Gon21513/RedisenoPEP/README.md

# Desarrollo de una placa de expansión para los agentes Pololu 3Pi+ que expanda sus capacidades dentro del ecosistema Robotat.
Este trabajo se desarrolló con el objetivo de **ampliar las capacidades de los agentes Pololu 3Pi+** utilizados en la plataforma de pruebas **Robotat**.  
Para lograrlo, se implementaron distintos módulos de expansión y funciones adicionales que extienden el alcance operativo del agente.

En primer lugar, se integraron **servomotores Feetech FT90M**, los cuales permiten dotar al agente de movimiento adicional y control de orientación en componentes periféricos.  
Asimismo, se incorporó una **cámara OpenMV Cam H7**, que permite **capturar imágenes o transmitir video en tiempo real** desde la perspectiva del agente. Esta cámara puede utilizarse tanto para realizar un *livestream* durante la ejecución de rutinas como para capturar fotogramas en momentos clave de operación.

Adicionalmente, se desarrolló un **algoritmo de estacionamiento automático** que posibilita el retorno del agente a una posición predefinida, evitando obstáculos en la plataforma. Esta funcionalidad contribuye a la automatización del proceso de pruebas y asegura un funcionamiento consistente del agente.

Todas las expansiones y el propio agente son controlados por un **TinyS3 (ESP32-S3)**, que proporciona comunicación **Wi-Fi** y permite la interacción desde un **cliente remoto**.  
El sistema fue diseñado para admitir instrucciones simples y extensibles, facilitando la integración con **múltiples lenguajes de programación**.

Este repositorio se basa en y utiliza como punto de partida parte del trabajo original desarrollado por **José Luis Álvarez Pineda**, disponible en el siguiente repositorio: 
[https://github.com/JoseLuisA-P/Tesis-ESP32-Pololu](https://github.com/JoseLuisA-P/Tesis-ESP32-Pololu)

El presente proyecto **extiende, adapta y optimiza** dicho trabajo para incorporar nuevas funcionalidades orientadas al control modular, la comunicación con cámara, el manejo de servomotores y la automatización de rutinas del agente dentro del entorno Robotat.
<center>
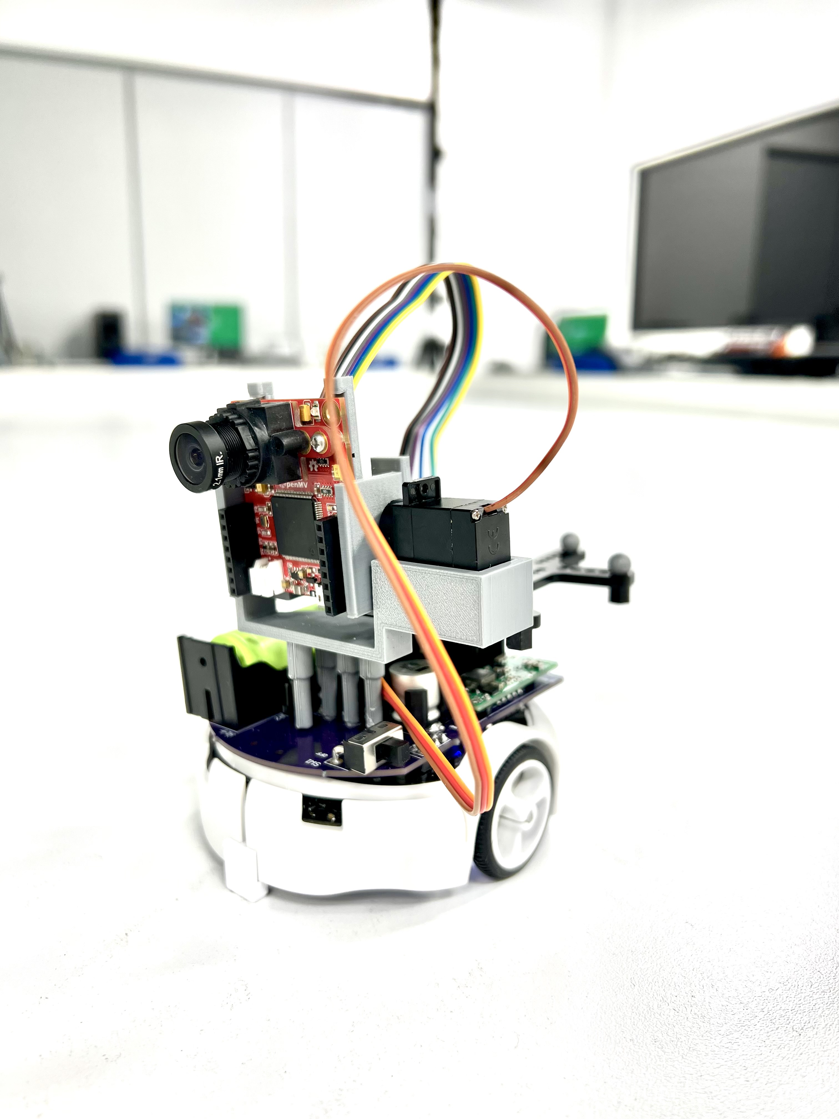
[picture p1: assets/IMG_4246.jpg]
  
</center>

Que contiene este repositorio:
- El firmware utilizado por la placa TinyS3.
- Los códigos para el control del agente y módulos desde Python.
- Manual para el ensamble de las placas de expansion y los modulos.
- Videos del funcionamiento general del sistema.
- Enlaces a las pruebas y validación del agente.

### Tabla de contenido:
- [Plataforma de trabajo](#Plataforma-de-trabajo)
- [Estructura del repositorio](#Estructura-del-repositorio)
- [Como ensamblar los modulos y placas](#Como-ensamblar-los-modulos-y-placas)

### Plataforma de trabajo

Platformio y ESPRESSIF

El firmware del agente se desarrolló utilizando la plataforma PlatformIO en VSCode, junto con el framework de ESP-IDF desarrollado como una extensión por ESPRESSIF. La elección de VSCode para este proyecto se debe a su alta flexibilidad para configurar el entorno de desarrollo, desde las alertas visuales hasta el manejo de errores y las diversas extensiones para interactuar con módulos y bibliotecas. Además, su fácil integración con GitHub y la gestión de versiones permitieron un desarrollo más eficiente.

Se utilizó la extensión de PlatformIO debido a las diversas herramientas que contiene para programar y preparar los entornos de trabajo para diversas placas y microcontroladores. Esta extensión permite crear proyectos específicos para cada placa, configurar sus características de manera sencilla, seleccionar las versiones del lenguaje a utilizar y manejar los errores de compilación. En el lado físico, permite programar las placas desde VSCode, utilizar el monitor serial para leer los mensajes de error y configurar acorde al puerto y velocidad de comunicación con la placa. Además, facilita compilar el proyecto y verificar los errores al cargar datos a las placas.

El framework de ESP-IDF se eligió principalmente por la fácil integración de FreeRTOS, lo que permite aprovechar al máximo las capacidades de la placa y optimizar su rendimiento multitarea. Además, este framework permite utilizar las bibliotecas desarrolladas por ESPRESSIF para un manejo eficiente de los módulos de las placas basadas en ESP32, proporcionando mayor flexibilidad en su configuración y permitiendo el uso del multiplexado de los pines para los distintos módulos.

Altium Designer

Para el desarrollo de las PCBs, se utilizó Altium Designer 2022. Aunque este software permite el uso de librerías de objetos comunes, fue necesario agregar librerías personalizadas para cada uno de los componentes adquiridos localmente sin un modelo definido. La elección de Altium Designer se debe a la variedad de herramientas que ofrece para el desarrollo de PCBs y la facilidad para modificar e interconectar proyectos.

Inventor

# Estructura del repositorio

El repositorio se encuentra organizado en las siguientes carpetas principales:

- **[PruebasCOMS](/PruebasCOMS)**  
  Contiene el proyecto utilizado para la configuración y generación del firmware del **TinyS3 (ESP32-S3)**, incluyendo los módulos de comunicación, control y manejo de periféricos.

- **[assets](/assets)**  
  Incluye las imágenes de referencia utilizadas dentro de este repositorio y en la documentación del proyecto.

- **[Videos](/Videos)**  
  Almacena videos que documentan el funcionamiento general del sistema.

- **[ControlCliente](/ControlCliente)**  
  Incluye los scripts desarrollados en **Python** para el control remoto del agente robótico, la comunicación con el TinyS3 y la visualización de datos.

- **[Camara](/Camara)**  
  Reúne los programas relacionados con la **comunicación y transmisión de video** entre el **TinyS3** y la **OpenMV Cam H7**.  
  Contiene los siguientes subapartados:

  - **openmv_stream**: código que debe cargarse directamente en la cámara OpenMV. Captura imágenes y las envía por SPI hacia el TinyS3.  
  - **PruebaCamara**: script para PC (VS Code, Thonny, etc.) que recibe y visualiza el streaming enviado por el microcontrolador.  
  - **MovimientoCamaraServo**: prueba para validar el control del servomotor encargado de orientar la cámara mediante el módulo MCPWM del TinyS3.  
  - **PruebasCamara**: código general de verificación de la cámara (inicialización, SPI, transmisión). Permite probar el streaming del sistema completo.  
  - **PruebaServoCamara**: ensayo que combina el control del servo y la captura de video, verificando la sincronización entre ambos.  

- **[Pruebas_Servos](/Pruebas_Servos)**  
  Códigos empleados para probar individualmente los servomotores conectados a la placa, comprobando amplitud angular, suavidad de movimiento y calibración PWM.

- **[PruebasBateria](/PruebasBateria)**  
  Programa de medición del nivel de batería mediante el ADC interno del ESP32-S3. Permite validar la correspondencia entre el voltaje medido y el estado real de la celda.

- **[ServosyRuedas](/ServosyRuedas)**  
  Código de prueba que controla únicamente las **ruedas y servos**, sin incluir el módulo de cámara. Se usa para calibración rápida del sistema de tracción.

- **[Servos_Ruedas_CAMARA](/Servos_Ruedas_CAMARA)**  
  Firmware que integra el **control de ruedas, servomotores y cámara** en una secuencia de pruebas completas:
  1. Movimiento de ruedas por un intervalo definido.  
  2. Movimiento de los servos de orientación.  
  3. Activación y verificación del streaming de la cámara.

### Como ensamblar los modulos y placas

Para ensamblar los módulos y placas utilizados en este trabajo, puede hacer referencia al documento **"ManualPololu.pdf"**. En este documento, encontrará una breve descripción de las placas, así como instrucciones detalladas sobre cómo ensamblar las placas y módulos. Además, se proporciona información sobre cómo montarlos y detalles sobre otros materiales adicionales que podrían ser necesarios en el proceso.

En el proceso de ensamblaje, se incluyen referencias a pruebas creadas para observar el correcto funcionamiento del agente antes de desplegarlo, lo que facilita el diagnóstico durante su ensamblaje.
