Gon21513/RedisenoPEP/figuras/figuras/altiumrv4.png

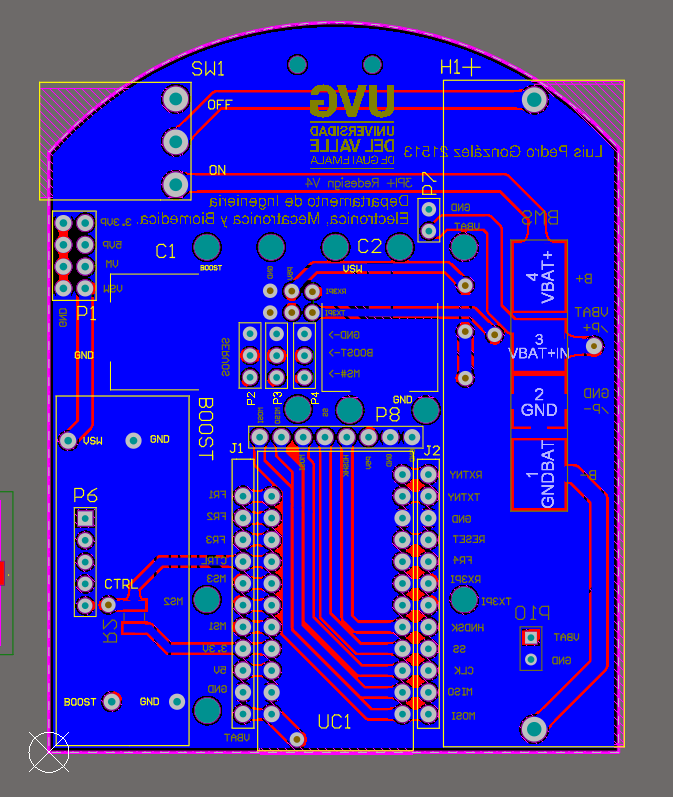
figuras/figuras/altiumrv4.png
