Gon21513/RedisenoPEP/figuras/figuras/altiumrv5.png

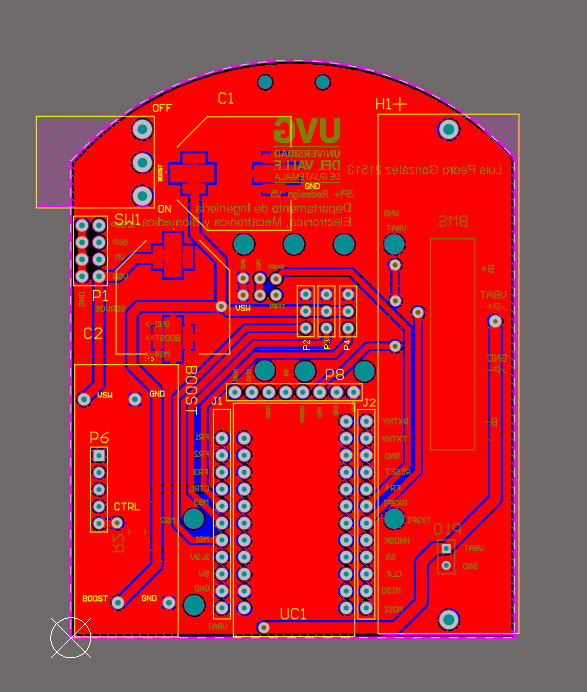
figuras/figuras/altiumrv5.png
