Gon21513/RedisenoPEP/figuras/figuras/basecamara.png

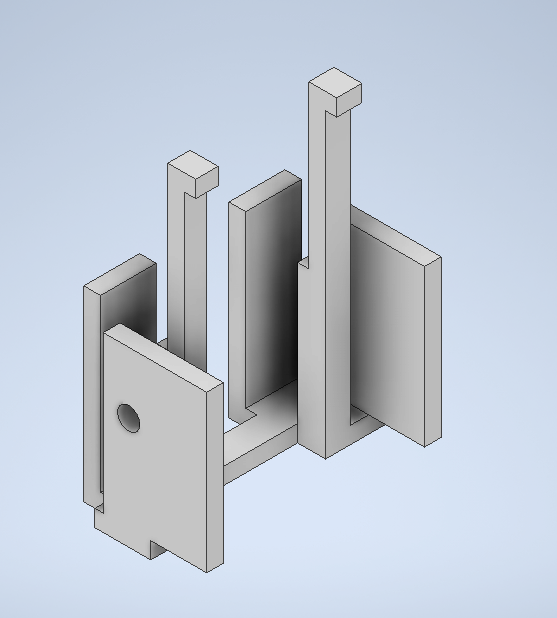
figuras/figuras/basecamara.png
