Gon21513/RedisenoPEP/figuras/figuras/basecamarafinal.png

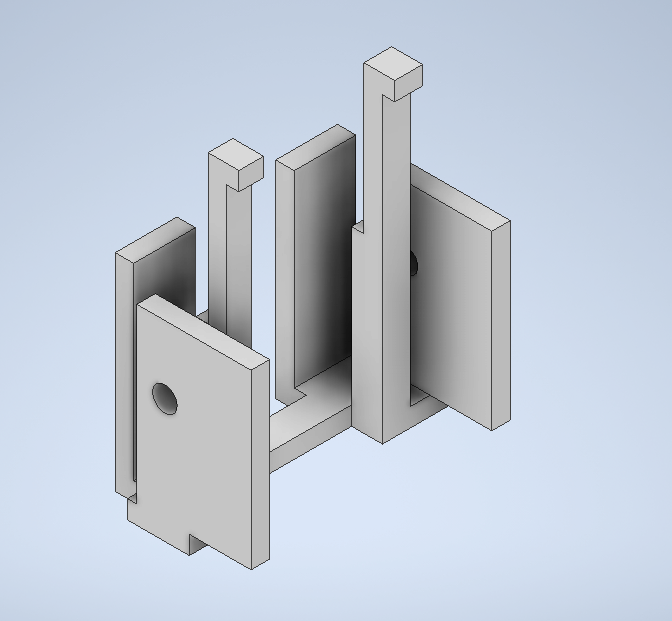
figuras/figuras/basecamarafinal.png
