Gon21513/RedisenoPEP/figuras/figuras/diagramaconexiones.png

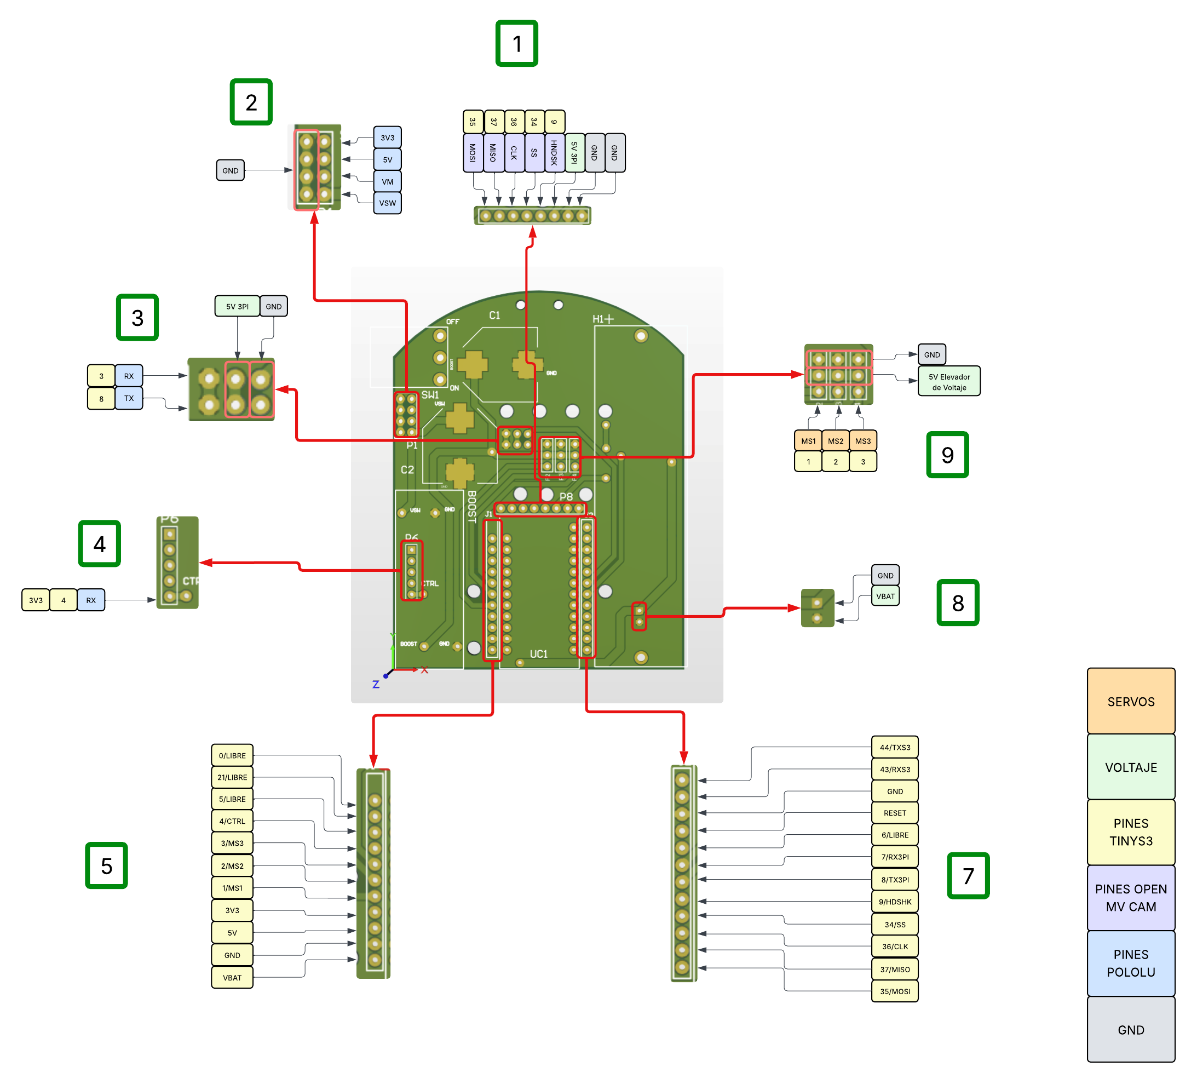
figuras/figuras/diagramaconexiones.png
