Gon21513/RedisenoPEP/figuras/figuras/diagramapolulu.png

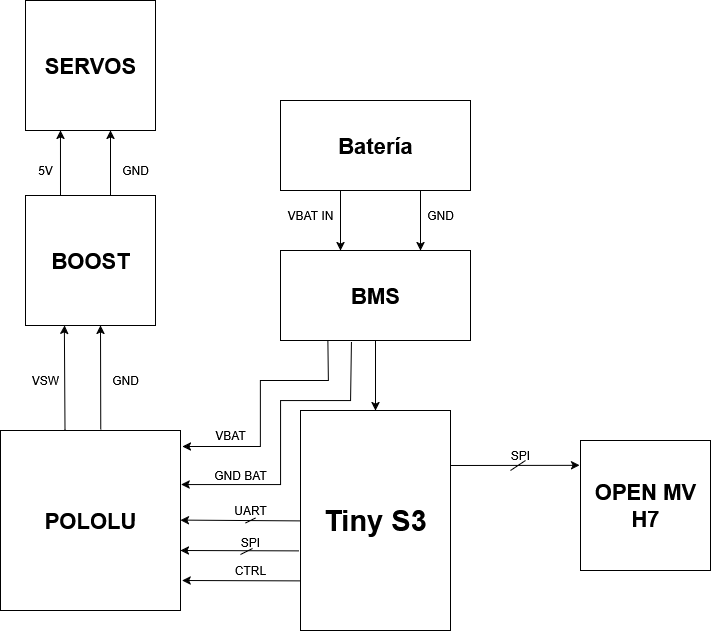
figuras/figuras/diagramapolulu.png
