Gon21513/RedisenoPEP/figuras/figuras/distribucion.png

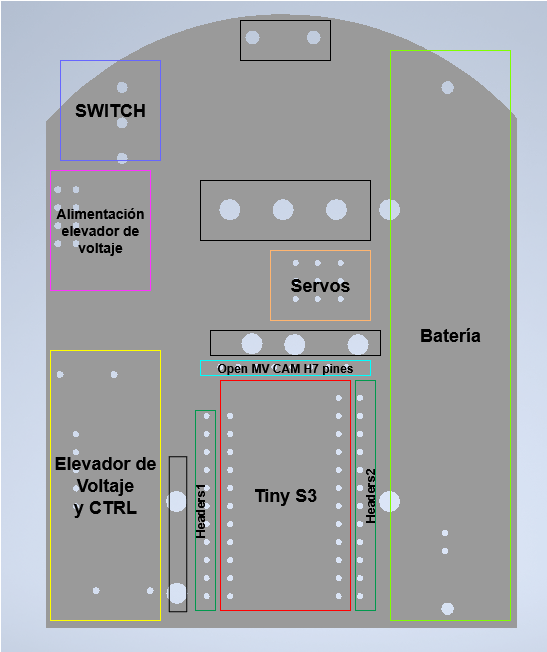
figuras/figuras/distribucion.png
