Gon21513/RedisenoPEP/figuras/figuras/Placa2025.jpg

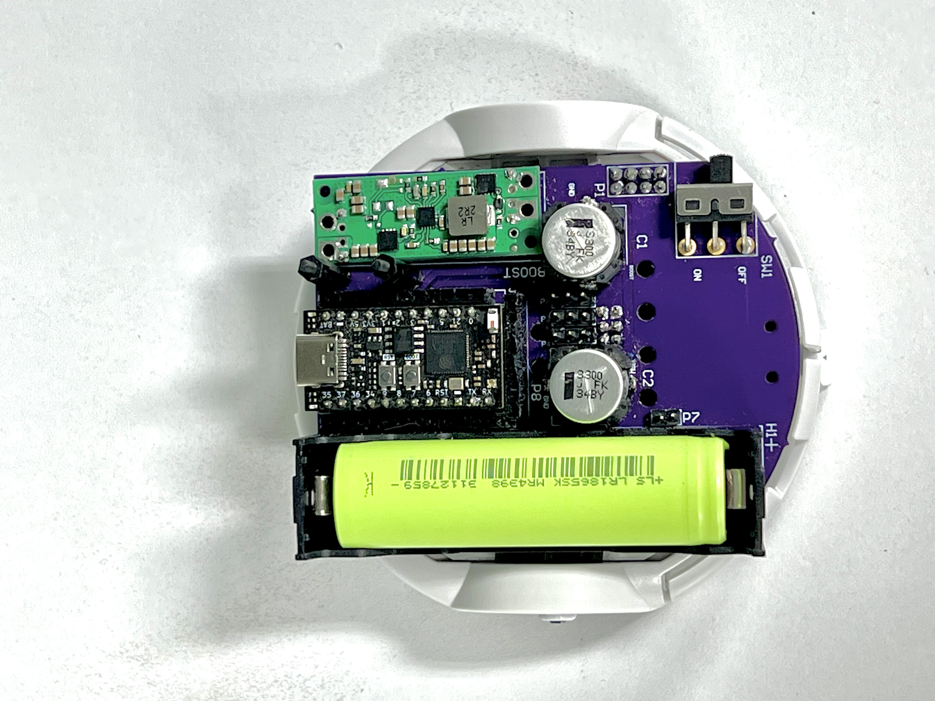
figuras/figuras/Placa2025.jpg
