Gon21513/RedisenoPEP/figuras/figuras/placarv5.png

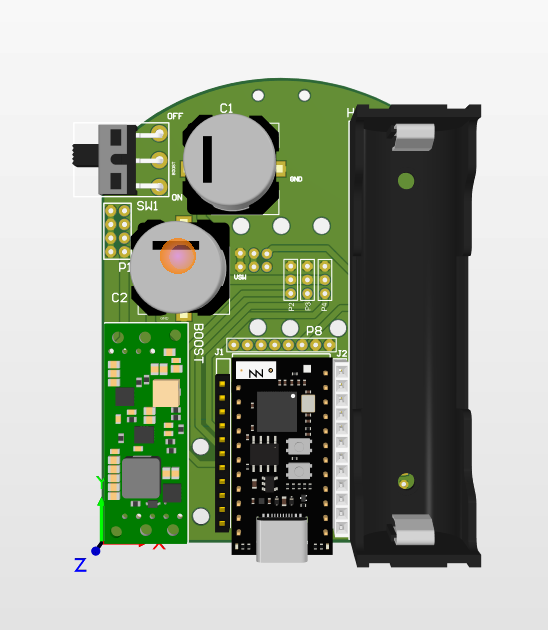
figuras/figuras/placarv5.png
