Gon21513/RedisenoPEP/figuras/figuras/VistaGeneral2024.jpeg

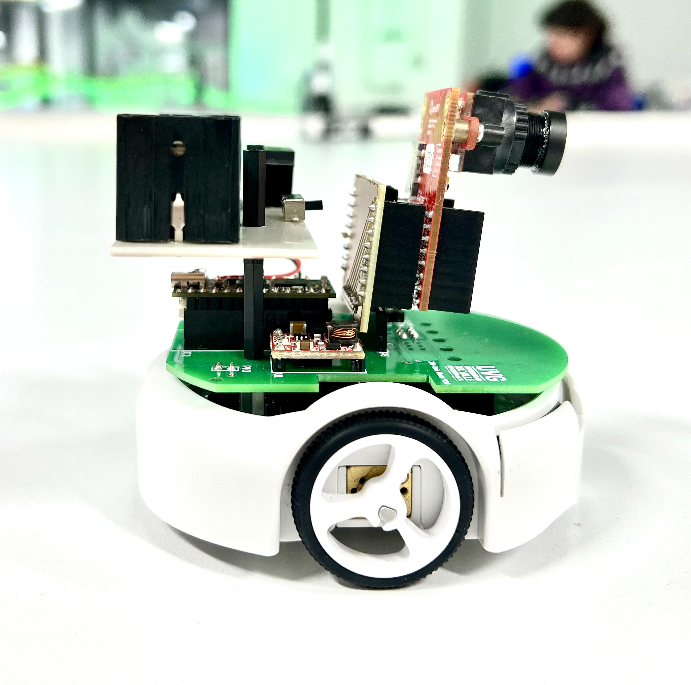
figuras/figuras/VistaGeneral2024.jpeg
