Gon21513/RedisenoPEP/figuras/figuras/montajeinventor.png

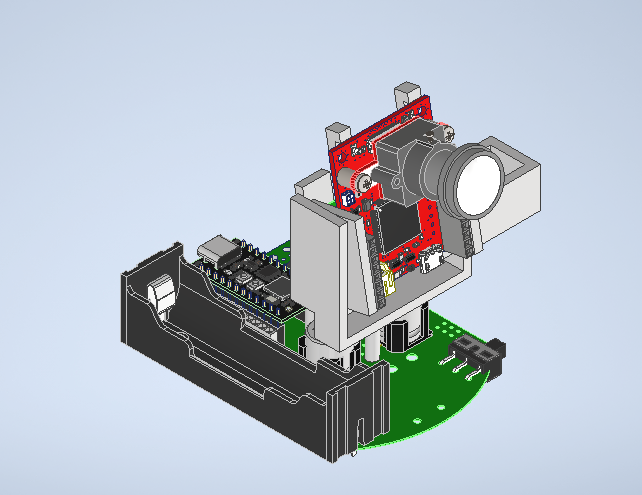
figuras/figuras/montajeinventor.png
