Gon21513/RedisenoPEP/Esquematicos/Esquematicos.PDF

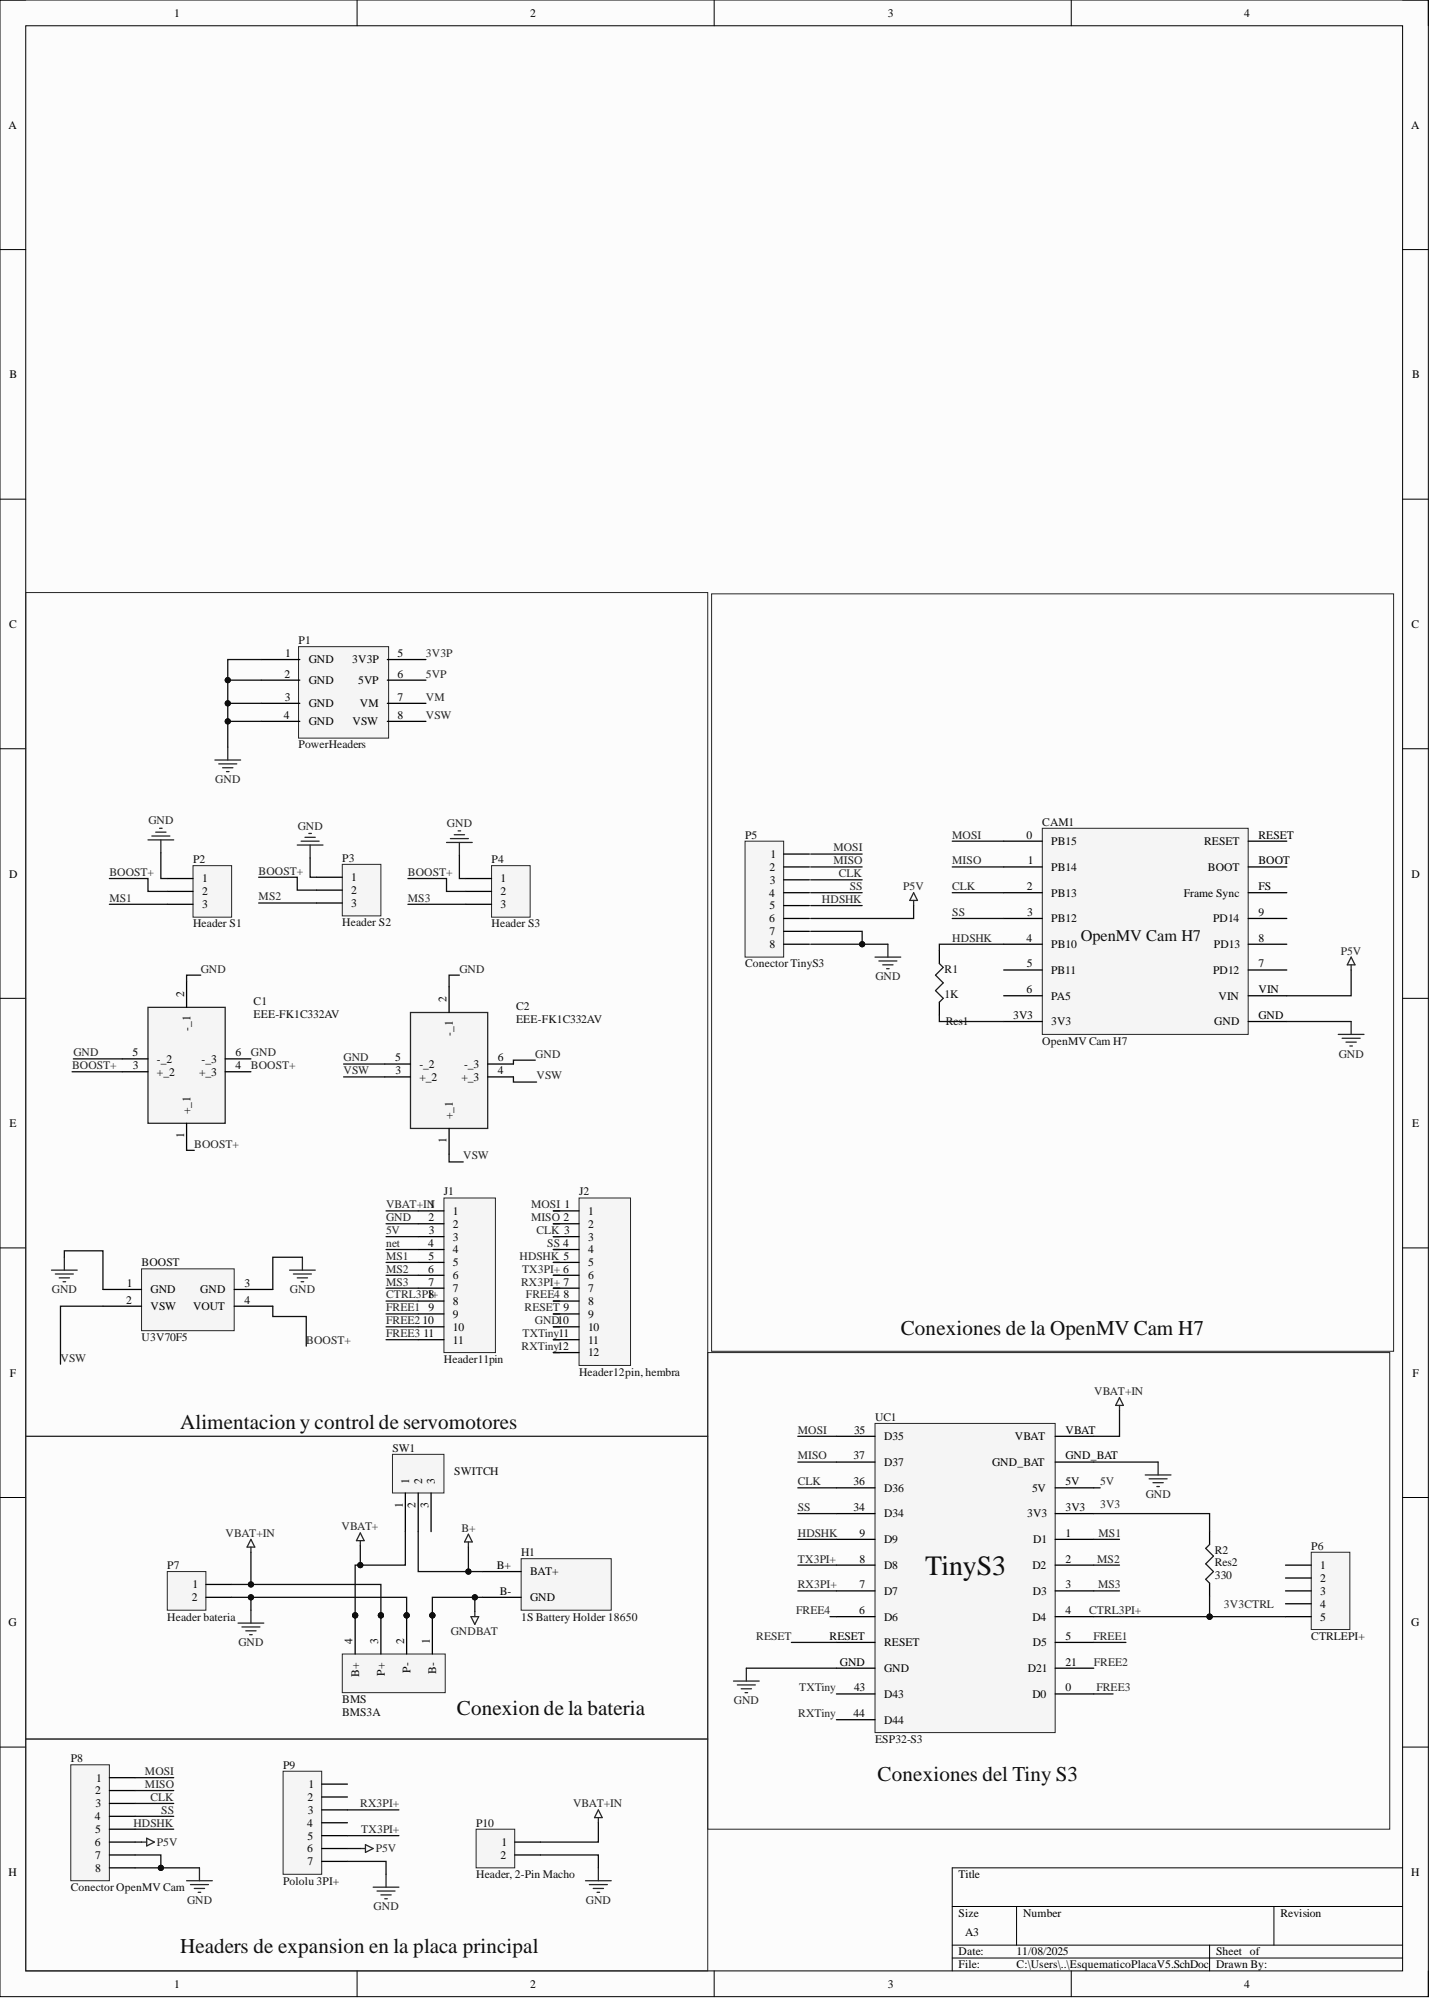
[picture p13: page 1]

Conexiones de la OpenMV Cam H7

Alimentacion y control de servomotores

Conexion de la bateria

Headers de expansion en la placa principal
