Gon21513/RedisenoPEP/(commit log)

2025-07-19 Pruebas servos
    Código básico solo para probar el funcionamiento de los servos y sus movimientos de 0 a 180 grados. Esto comprueba el buen funcionamiento y conexión de los servos.
2025-07-26 Pruebas Carga Bateria y Velocidades
2025-09-08 Prueba de Camara
    Stram en escala de grises
2025-09-08 Código para la cámara
2025-09-11 Movimiento general s servos, ruedas y funcionamiento de cámara se añade
2025-11-08 Actualiza descripciones y corrige errores en README
    Se actualizaron las descripciones de los componentes utilizados, incluyendo la versión de Altium Designer y el nombre del documento de ensamblaje. Se corrigieron errores tipográficos y se mejoró la organización del contenido.
2025-11-08 Actualiza la sección de descripción del README
    Se amplió la descripción del proyecto, detallando las capacidades de los módulos de expansión y el control del agente.
2025-11-08 Revise README for camera script configuration and usage
    Updated the README to clarify the script's functionality and usage steps for the OpenMV Cam H7 and TinyS3 integration.
2025-11-08 Fix typo in README.md regarding camera scripts
